chatelao/RP2040-Based-Tester-Brains-PCB/Adafruit RP2040 Tester Brains rev A.kicad_sch

## KiCad design Adafruit RP2040 Tester Brains rev A.kicad_sch (2024-02-29)

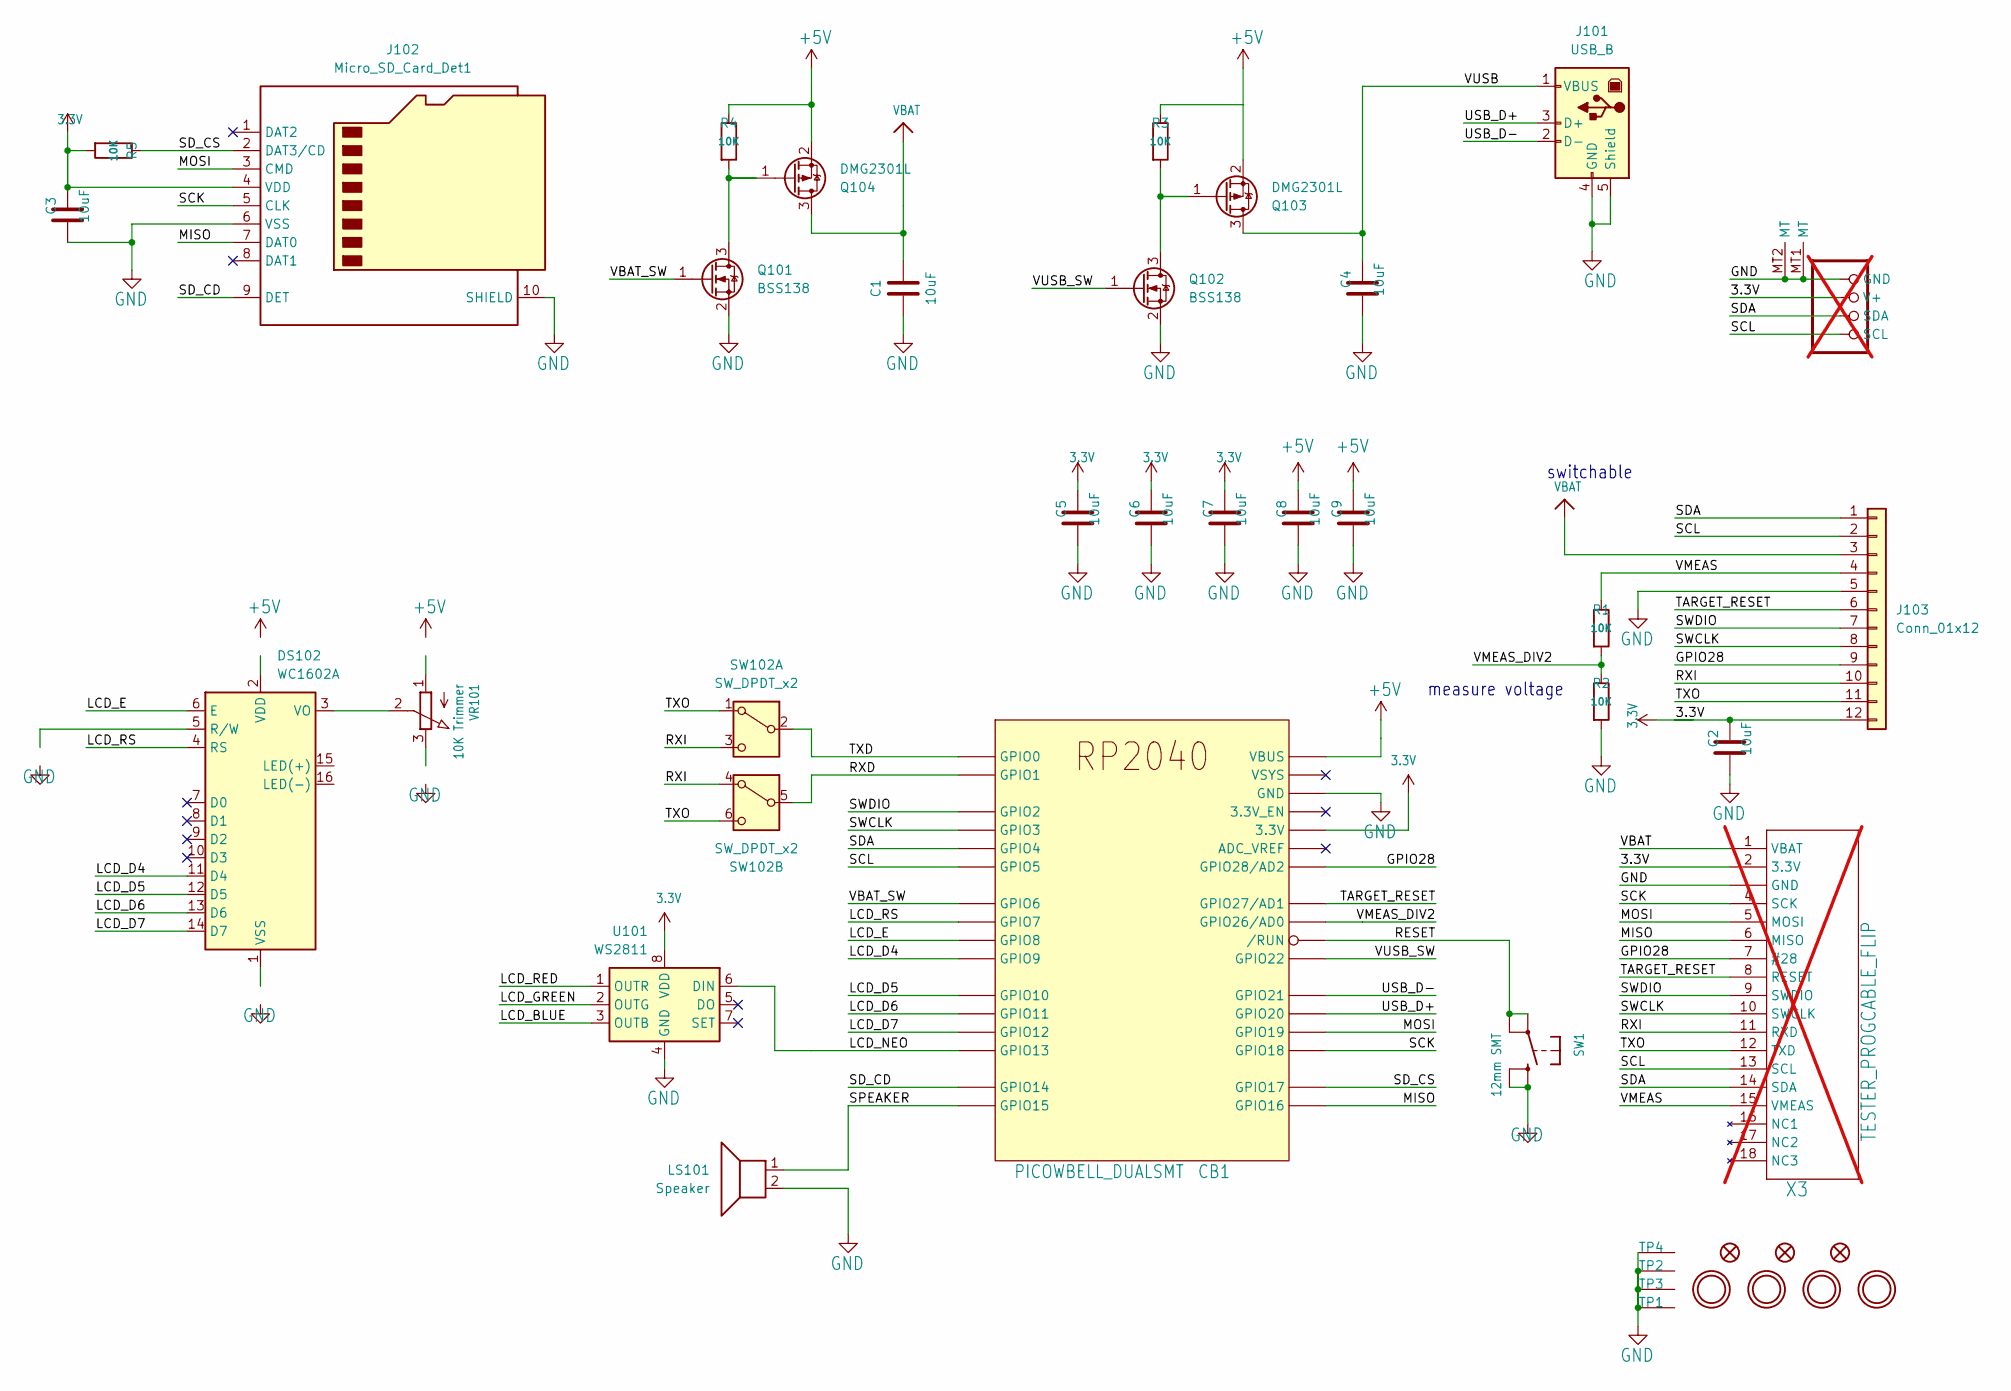
[picture p1: schematic Adafruit RP2040 Tester Brains rev A.kicad_sch]

Parts:
C1, C2, C3, C4, C5, C6, C7, C8, C9: 10uF; C_0805_2012Metric_Pad1.18x1.45mm_HandSolder
CB1: PICOWBELL_DUALSMT
CONN1: STEMMA_I2C_QT; JST_SH4; not fitted
DS102: WC1602A
FID1, FID2, FID3: FIDUCIAL_1MM; Fiducial_1mm_Mask3mm
J101: USB_B; USB_A_Molex_67643_Horizontal
J102: Micro_SD_Card_Det1; microSD_HC_Molex_104031-0811
J103: Conn_01x12; PinSocket_1x12_P2.54mm_Horizontal
LS101: Speaker; Buzzer_12x9.5RM7.6
Q101, Q102: BSS138; SOT-23
Q103, Q104: DMG2301L; SOT-23
R1, R2, R3, R4, R5: 10K; R_0603_1608Metric_Pad0.98x0.95mm_HandSolder
SW1: 12mm SMT; B3F-40XX-SMT
SW102: SW_DPDT_x2; SW_CK_JS202011AQN_DPDT_Angled
TP1, TP2, TP3, TP4: SEWTAP_SMTNUTM3; SMT_NUT_3MM
U101: WS2811; SOIC-8_3.9x4.9mm_P1.27mm
U$7, U$8, U$9, U$10: MOUNTINGHOLE3.0THIN; MountingHole_3.2mm_M3
VR101: 10K Trimmer; TRIMPOT_BOURNS_TC33X-2
X3: TESTER_PROGCABLE_FLIP; FPC_0.5MM_18PIN; not fitted

Connections:
3.3V: C2.1, C3.1, C5.1, C6.1, C7.1, CB1.S71 (3.3V), CB1.S72 (3.3V), CONN1.2 (V+), J102.4 (VDD), J103.12, R5.2, U101.8 (VDD), X3.2 (3.3V)
+5V: C8.1, C9.1, CB1.S79 (VBUS), CB1.S80 (VBUS), Q103.2 (S), Q104.2 (S), R4.1
GND: C1.2, C2.2, C3.2, C4.2, C5.2, C6.2, C7.2, C8.2, C9.2, CB1.S5 (GND), CB1.S6 (GND), CB1.S15 (GND), CB1.S16 (GND), CB1.S25 (GND), CB1.S26 (GND), CB1.S35 (GND), CB1.S36 (GND), CB1.S45 (GND), CB1.S46 (GND), CB1.S55 (GND), CB1.S56 (GND), CB1.S65 (GND), CB1.S66 (GND), CB1.S75 (GND), CB1.S76 (GND), CONN1.1 (GND), CONN1.MT1 (MT), CONN1.MT2 (MT), J101.4 (GND), J101.5 (Shield), J102.6 (VSS), J102.10 (SHIELD), J103.5, LS101.2, Q101.2 (S), Q102.2 (S), R2.2, SW1.P$3 (S), SW1.P$4 (S1), TP1.P$1, TP2.P$1, TP3.P$1, TP4.P$1, U101.4 (GND), X3.3 (GND), X3.SUPPORT1 (GND), X3.SUPPORT2 (GND)
GPIO28: CB1.S67 (GPIO28/AD2), CB1.S68 (GPIO28/AD2), J103.9, X3.7 (#28)
LCD_BLUE: U101.3 (OUTB)
LCD_D4: CB1.S23 (GPIO9), CB1.S24 (GPIO9), DS102.11 (D4)
LCD_D5: CB1.S27 (GPIO10), CB1.S28 (GPIO10), DS102.12 (D5)
LCD_D6: CB1.S29 (GPIO11), CB1.S30 (GPIO11), DS102.13 (D6)
LCD_D7: CB1.S31 (GPIO12), CB1.S32 (GPIO12), DS102.14 (D7)
LCD_E: CB1.S21 (GPIO8), CB1.S22 (GPIO8), DS102.6 (E)
LCD_GREEN: U101.2 (OUTG)
LCD_NEO: CB1.S33 (GPIO13), CB1.S34 (GPIO13), U101.6 (DIN)
LCD_RED: U101.1 (OUTR)
LCD_RS: CB1.S19 (GPIO7), CB1.S20 (GPIO7), DS102.4 (RS)
MISO: CB1.S41 (GPIO16), CB1.S42 (GPIO16), J102.7 (DAT0), X3.6 (MISO)
MOSI: CB1.S49 (GPIO19), CB1.S50 (GPIO19), J102.3 (CMD), X3.5 (MOSI)
unnamed: CB1.S69 (ADC_VREF), CB1.S70 (ADC_VREF)
unnamed: CB1.S73 (3.3V_EN), CB1.S74 (3.3V_EN)
unnamed: CB1.S77 (VSYS), CB1.S78 (VSYS)
unnamed: DS102.3 (VO), VR101.2 (S)
unnamed: Q101.3 (D), Q104.1 (G), R4.2
unnamed: Q102.3 (D), Q103.1 (G), R3.2
RESET: CB1.S59 (/RUN), CB1.S60 (/RUN), SW1.P$1, SW1.P$2 (P1)
RXD: CB1.S3 (GPIO1), CB1.S4 (GPIO1), SW102.5 (B)
RXI: J103.10, SW102.3 (C), SW102.4 (A), X3.11 (RXD)
SCK: CB1.S47 (GPIO18), CB1.S48 (GPIO18), J102.5 (CLK), X3.4 (SCK)
SCL: CB1.S13 (GPIO5), CB1.S14 (GPIO5), CONN1.4 (SCL), J103.2, X3.13 (SCL)
SDA: CB1.S11 (GPIO4), CB1.S12 (GPIO4), CONN1.3 (SDA), J103.1, X3.14 (SDA)
SD_CD: CB1.S37 (GPIO14), CB1.S38 (GPIO14), J102.9 (DET)
SD_CS: CB1.S43 (GPIO17), CB1.S44 (GPIO17), J102.2 (DAT3/CD), R5.1
SPEAKER: CB1.S39 (GPIO15), CB1.S40 (GPIO15), LS101.1
SWCLK: CB1.S9 (GPIO3), CB1.S10 (GPIO3), J103.8, X3.10 (SWCLK)
SWDIO: CB1.S7 (GPIO2), CB1.S8 (GPIO2), J103.7, X3.9 (SWDIO)
TARGET_RESET: CB1.S63 (GPIO27/AD1), CB1.S64 (GPIO27/AD1), J103.6, X3.8 (RESET)
TXD: CB1.S1 (GPIO0), CB1.S2 (GPIO0), SW102.2 (B)
TXO: J103.11, SW102.1 (A), SW102.6 (C), X3.12 (TXD)
USB_D+: CB1.S51 (GPIO20), CB1.S52 (GPIO20), J101.3 (D+)
USB_D-: CB1.S53 (GPIO21), CB1.S54 (GPIO21), J101.2 (D-)
VBAT: C1.1, J103.3, Q104.3 (D), X3.1 (VBAT)
VBAT_SW: CB1.S17 (GPIO6), CB1.S18 (GPIO6), Q101.1 (G)
VMEAS: J103.4, R1.1, X3.15 (VMEAS)
VMEAS_DIV2: CB1.S61 (GPIO26/AD0), CB1.S62 (GPIO26/AD0), R1.2, R2.1
VUSB: C4.1, J101.1 (VBUS), Q103.3 (D)
VUSB_SW: CB1.S57 (GPIO22), CB1.S58 (GPIO22), Q102.1 (G)

Notes on the sheet:
measure voltage
switchable
