chatelao/RP2040-Based-Tester-Brains-PCB/(commit log)

2024-02-29 Converted from Eagle to KiCAD
    [Adafruit RP2040 Tester Brains rev A.brd, Adafruit RP2040 Tester Brains rev A.kicad_pcb, Adafruit RP2040 Tester Brains rev A.kicad_sch, Adafruit RP2040 Tester Brains rev A.sch]
2024-02-29 More migration to kKiCAD
    [Adafruit RP2040 Tester Brains rev A.kicad_pcb, Adafruit RP2040 Tester Brains rev A.kicad_sch]
